VAleSh-Soft/selfWatering/docs/Schematic_Self_Watering.png

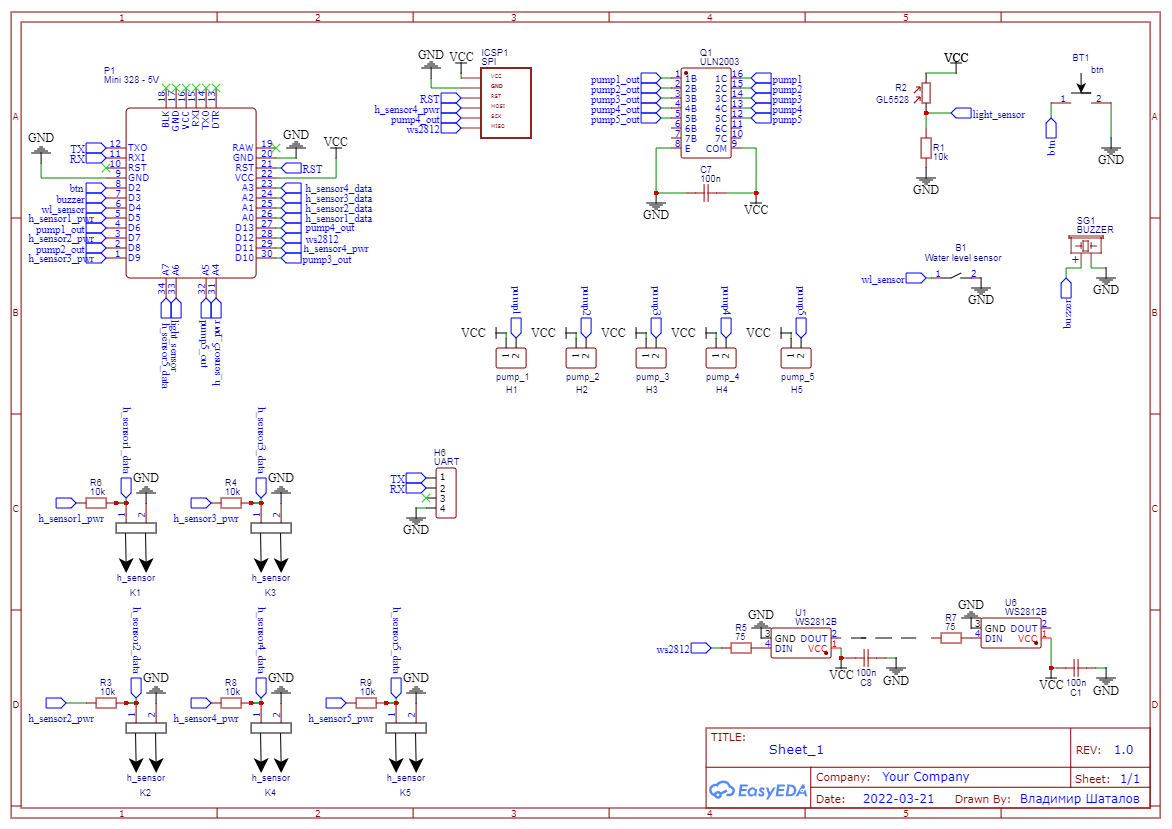
docs/Schematic_Self_Watering.png
